MichaelRossPSU/JAM/README.md

# JAM
EE 403W Repository - John Darling, Alex Swan Yi, Michael Ross

John Darling (darling.johnt@gmail.com)
Thadoe Swan Yi (tis5323@psu.edu)
Michael Ross (mur5009@psu.edu)
