MichaelRossPSU/JAM/DESIGN_OUTPUTS/Design Review.pptx

## “Raspberry Jam” Monitoring your world

JAM

## JAM Home Monitoring System

JAM

- Our Goal: Design an inexpensive and configurable home security that can be monitored from anywhere in the world
- Our design will be able to do the following:
  1. Detect Motion
  2. Sound an Alarm
  3. Stream live video
  4. Measure room temperature and brightness levels
  5. Provide system alert notifications via email
  6. All features configurable and accessible remotely

## Compared to the Market

JAM

- Inexpensive relative to a subscription based home security system
- Price point lower than comparable solutions (Nest)
- Easy to set up
- Offers more user customization for power users

## Technical Specifications/Performance

JAM

Feature | Specifications
Size and weight | 120 cubic inches; 3 lbs
Video Output | 1080p continuous video stream
Power Consumption | 0.08 kWh/month if active at all times
Motion Sensor Range (Maximum room size) | 20 feet
Alarm | Store up to 5 custom alarm sounds at any time
Connectivity | Any device with an internet connection and HTML5 capable web browser
Hardware Add-ons | Temperature Sensor, Light sensor

## Design Approach

On Board PCB

JAM

Light Sensing Diode

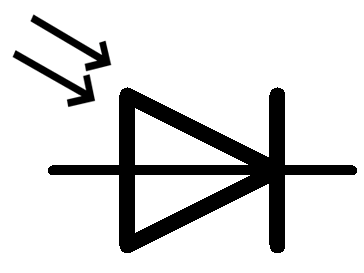
[picture p1: figure]
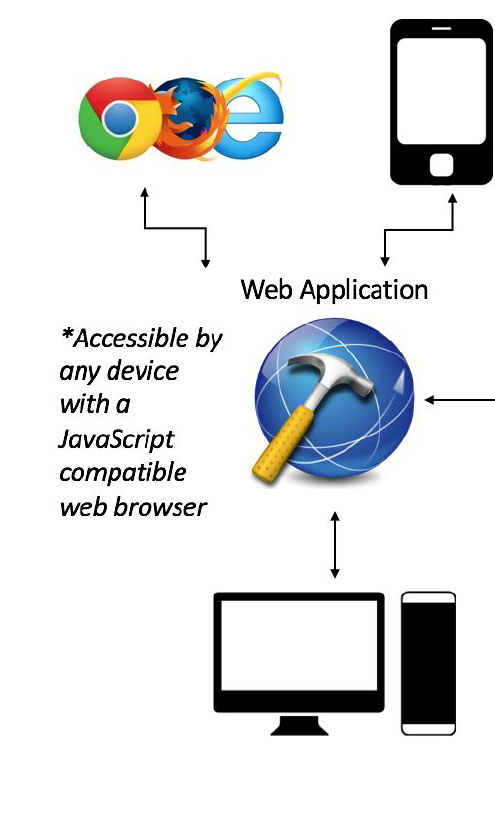
[picture p2: figure]
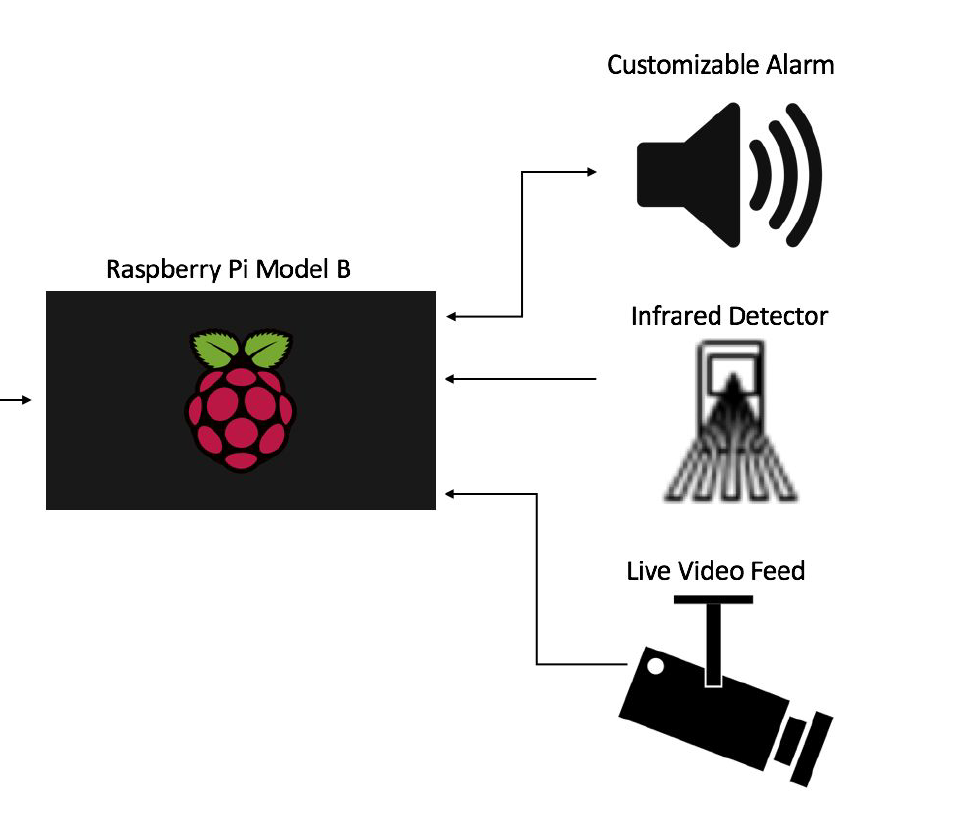
[picture p3: figure]

Web Socket

Temperature Sensor

## Software Flow

JAM

Server side

Client side

JAM Webpage
(HTML5, CSS, JavaScript)

PI Server
(Apache)

Data Acquisition/Processing (Python)

Tornado Web socket
(Python)

## Progress

JAM

- Web Server: Running
- Web socket Server: Running
- Able to control GPIO pins via the Web Page
- Sub Circuits Designed
- PCB Design Completed

## What’s left?

- Still to finish:
1. Scripting for web application
2. Web page design
- Yet to start:
1. Python scripting for hardware
2. Outfit PCB with hardware
3. Building and integrating into enclosure

JAM

## Tradeoffs of our Design

JAM

- Current server structure not feasible for mass production
- Remote Access methods create security loopholes
- Does not have built in authority alert system
- Video feed not practical at night
- Prototype size
- Limited audio output

## Design Responsibilities

- Mike – Circuit Design
- Thadoe – Website Design
- John – Software Design
- This design work flow is the most efficient way to ensure that one part of the project is not slowed down because of setbacks in another
- The longest journey lies ahead…Getting raw data from our PCB through the pi and finally to our webpage

JAM

## Questions?

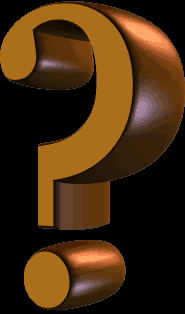
[picture p4: figure]
