MichaelRossPSU/JAM/Grades/Design Review 1 Grades.xlsx

Rasberri Jam | External Reviewers |  |  |  | Students
Presentation Item | C | M | L | E |  |  |  |  |  |  |  |  | Avg External Reviewer Score | AVG Student Score | Weighted | Final Score
Did you understand the team's technical approach and how their proposed solution is supposed to work? | 5 | 7 | 5 | 7 | 7 | 10 | 10 | 7 | 10 | 10 | 10 | 9 | 6 | 9.125 | 7.5625 | 72.3125
Rate the quality of the team's specifications. Were they stated clearly and did they describe quantifiable performance measures? | 2 | 7 | 5 | 8 | 8 | 9 | 9 | 10 | 2 | 10 | 9 | 10 | 5.5 | 8.375 | 6.9375
Did team show any experimental data or technical progress? | 3 | 5 | 2 | 8 | 8 | 8 | 7 | 8 | 10 | 9 | 8 | 9 | 4.5 | 8.375 | 6.4375
Did team know what their problem areas were? | 4 | 8 | 4 | 9 | 10 | 8 | 9 | 10 | 10 | 8 | 10 | 8 | 6.25 | 9.125 | 7.6875
Rate overall progress on the project to-date | 3 | 6 | 3 | 7 | 10 | 9 | 10 | 8 | 7 | 10 | 10 | 9 | 4.75 | 9.125 | 6.9375
Rate team's explanations of project challenges and risks | 4 | 7 | 5 | 8 | 9 | 10 | 9 | 7 | 8 | 10 | 9 | 9 | 6 | 8.875 | 7.4375
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
