MichaelRossPSU/JAM/DESIGN_OUTPUTS/Board Schematic.brd

## EAGLE design DESIGN_OUTPUTS/Board Schematic.brd (2016-03-14)

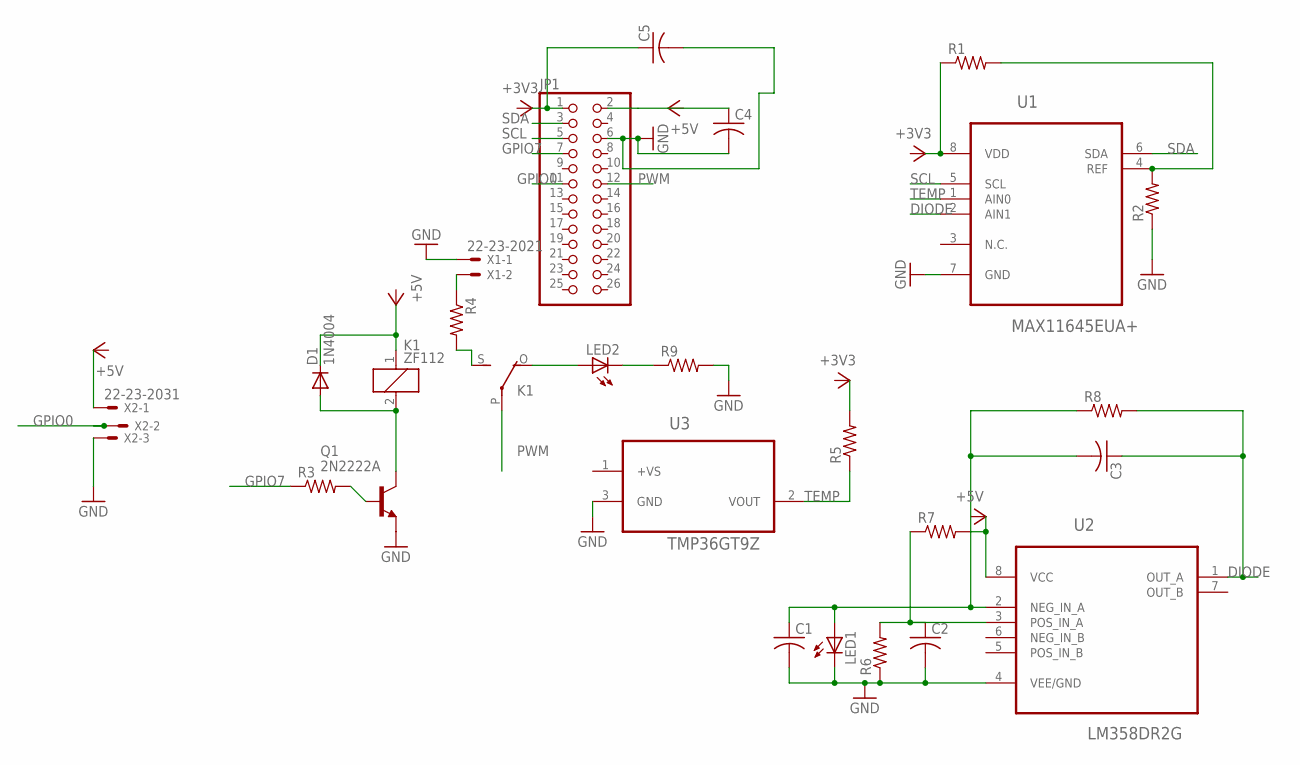
[picture p20: schematic Board Schematic.sch]

Parts:
C1, C2, C3, C4, C5: C-USC1206; C1206
D1: 1N4004; DO41-10
JP1: PINHD-2X13; 2X13
K1: ZF112
LED1, LED2: LED5MM
Q1: 2N2222A; TO18
R1, R2, R3, R4, R5, R6, R7, R8, R9: R-US_R1206; R1206
U1: MAX11645EUA+; SOP65P490X110-8N
U2: LM358DR2G; SOIC127P600X175-8N
U3: TMP36GT9Z; TO127P254X533-3P
X1: 22-23-2021
X2: 22-23-2031

Connections:
3V3: C5.1, JP1.1, R1.1, R5.2, U1.8 (VDD)
+5V: C4.1, D1.C, JP1.2, K1.1, R7.2, U2.8 (VCC), X2.1
+VS: U3.1 (+VS)
DIODE: C3.1, R8.2, U1.2 (AIN1), U2.1 (OUT_A)
GND: C1.2, C2.2, C4.2, C5.2, JP1.6, LED1.K (C), Q1.1 (E), R2.1, R6.1, R9.2, U1.7 (GND), U2.4 (VEE/GND), U3.3 (GND), X1.1, X2.3
GPIO0: JP1.11, X2.2
GPIO7: JP1.7, R3.1
unnamed: R1.2, R2.2, U1.4 (REF)
unnamed: R4.1, X1.2
unnamed: C1.1, C3.2, LED1.A, R8.1, U2.2 (NEG_IN_A)
unnamed: C2.1, R6.2, R7.1, U2.3 (POS_IN_A)
unnamed: K1.O, LED2.A
unnamed: D1.A, K1.2, Q1.3 (C)
unnamed: Q1.2 (B), R3.2
unnamed: K1.S, R4.2
unnamed: LED2.K (C), R9.1
PWM: JP1.12, K1.P
SCL: JP1.5, U1.5 (SCL)
SDA: JP1.3, U1.6 (SDA)
TEMP: R5.1, U1.1 (AIN0), U3.2 (VOUT)

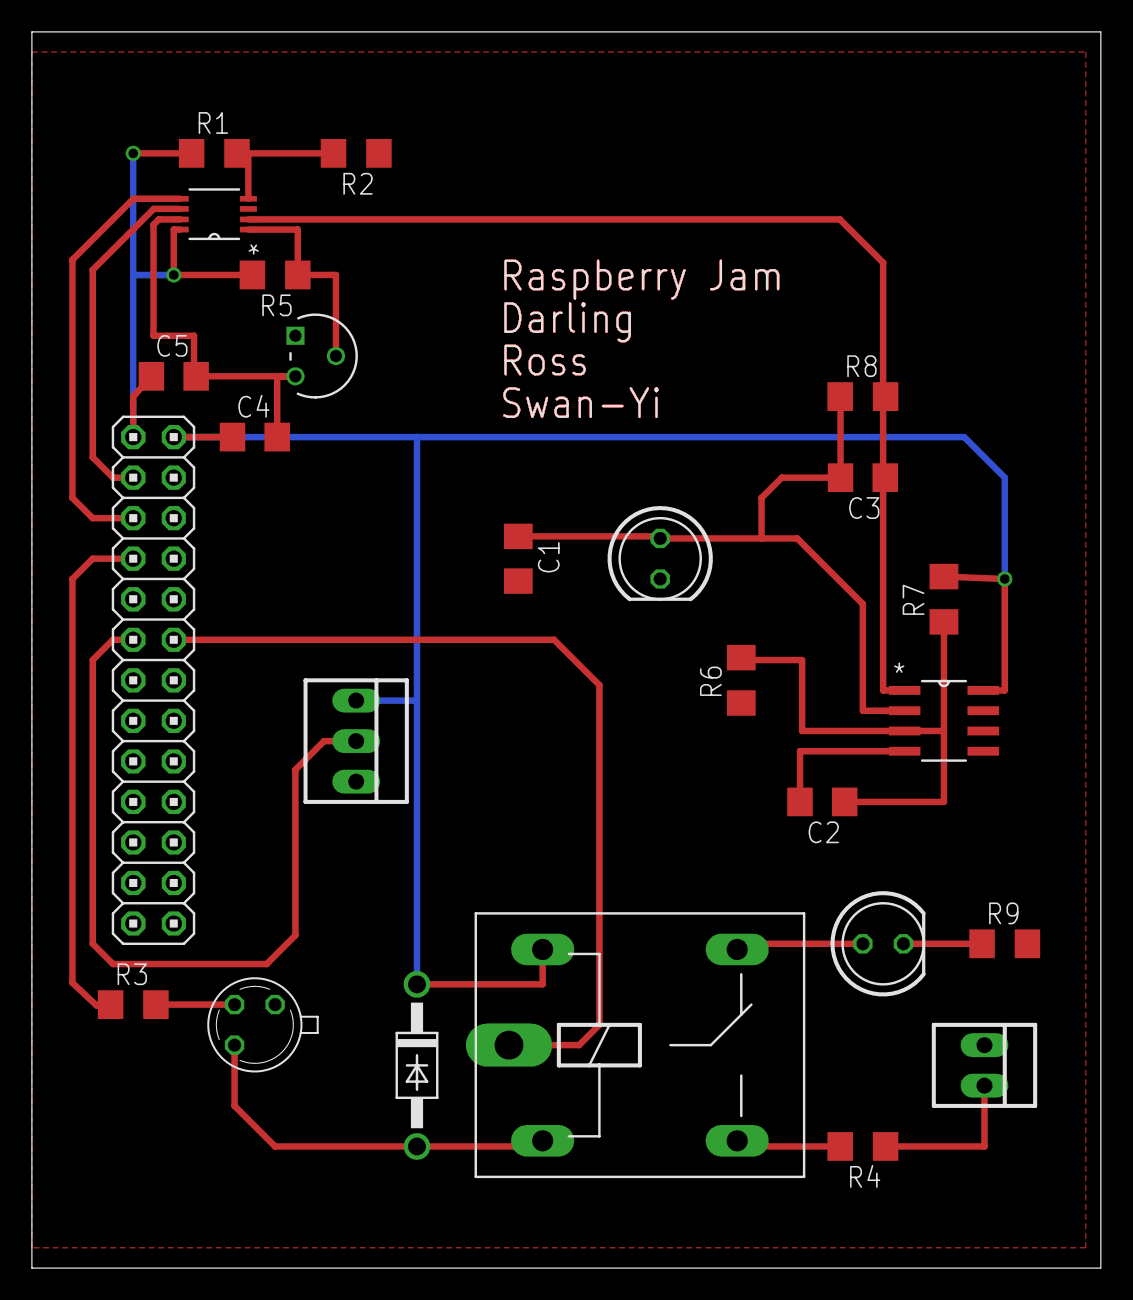
[picture p21: board Board Schematic.brd from above]

Board: 2 copper layers, 67.0 x 77.5 mm, 25 parts (0 on the bottom side), 19 nets.
