MichaelRossPSU/JAM/(commit log)

2016-02-15 Added index.html in CURRENT_VERSIONS folder
2016-02-15 Added web socket python code
2016-03-14 Added Eagle Board File
    [Board Schematic.brd]
2016-03-16 Design Review Grades
    [Design Review 1 Grades.xlsx]
2016-04-19 Added new index.html and IR sensor code.
